rolandblok/sensor_satellite/photo/epaper.busy.broken.trace.jpg

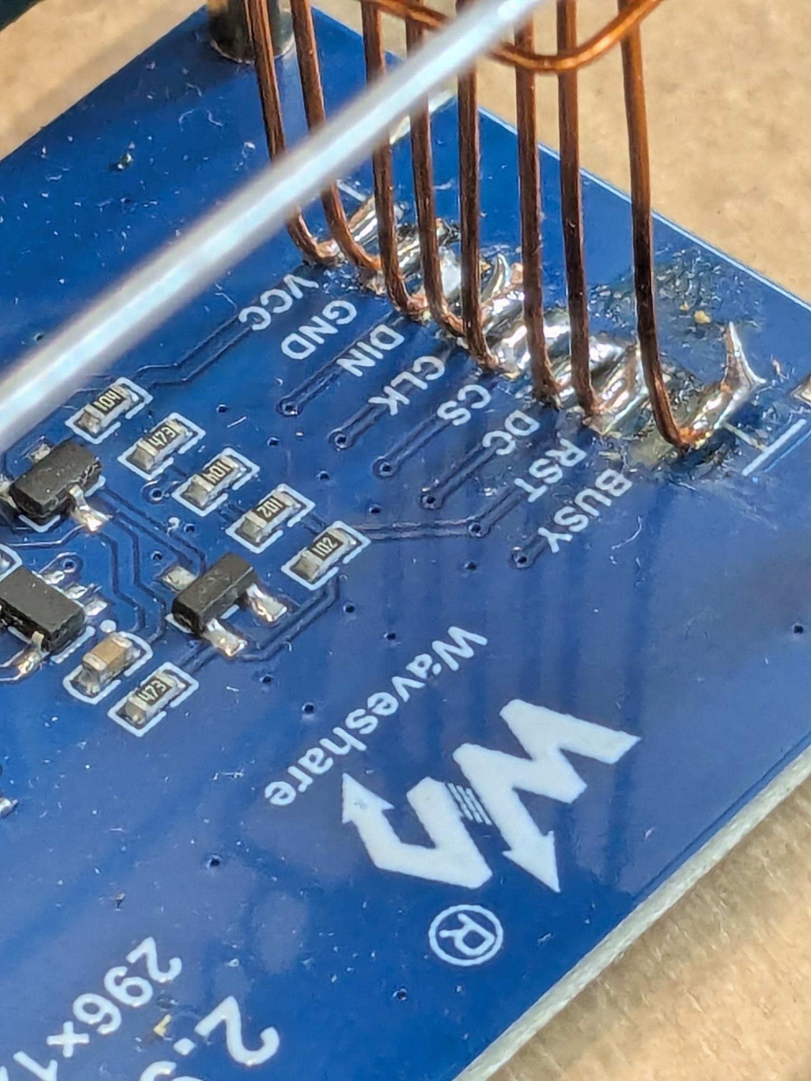
photo/epaper.busy.broken.trace.jpg
