rolandblok/sensor_satellite/photo/PXL_20261002_092657248 (Medium).jpg

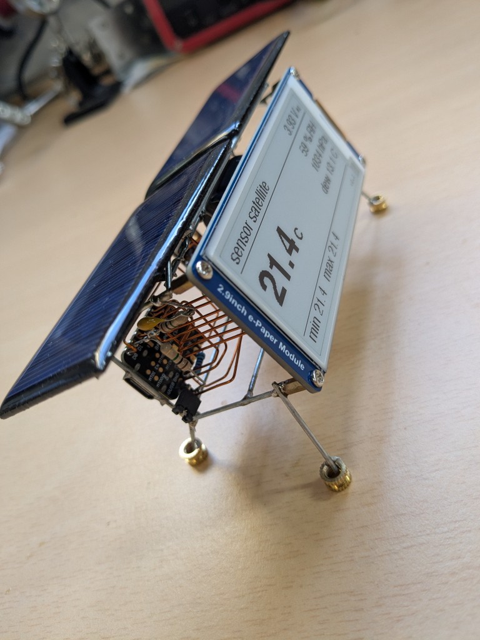
photo/PXL_20261002_092657248 (Medium).jpg
