rolandblok/sensor_satellite/photo/PXL_20261002_092710052 (Medium).jpg

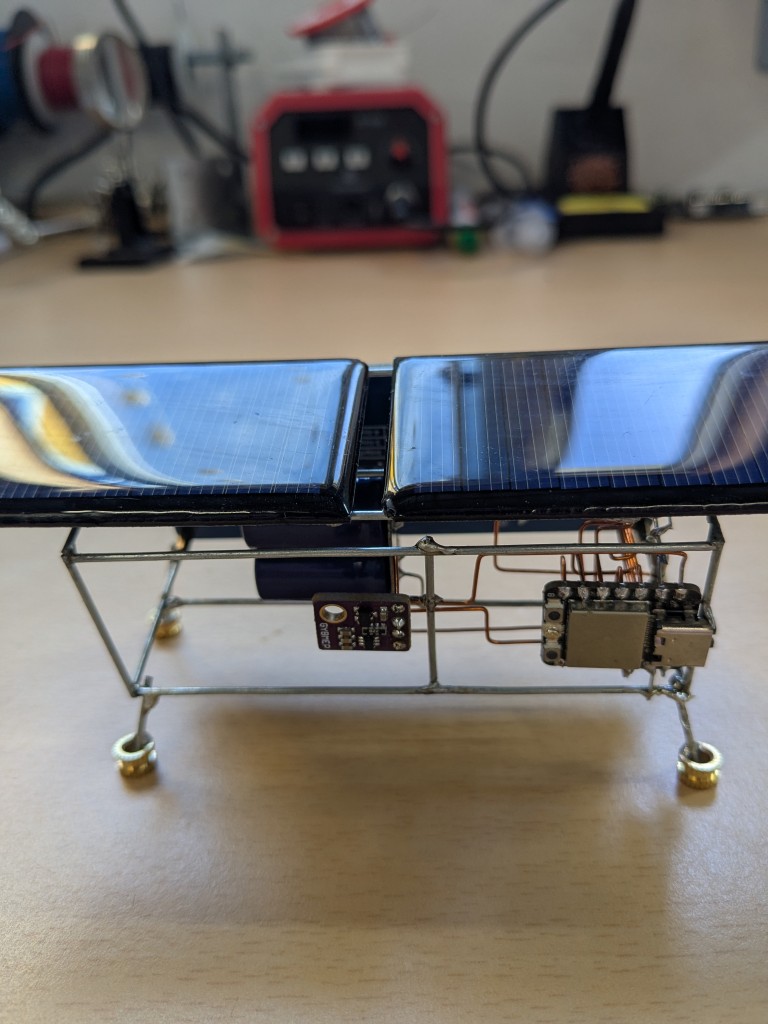
photo/PXL_20261002_092710052 (Medium).jpg
