rolandblok/sensor_satellite/photo/PXL_20261002_092730663 (Medium).jpg

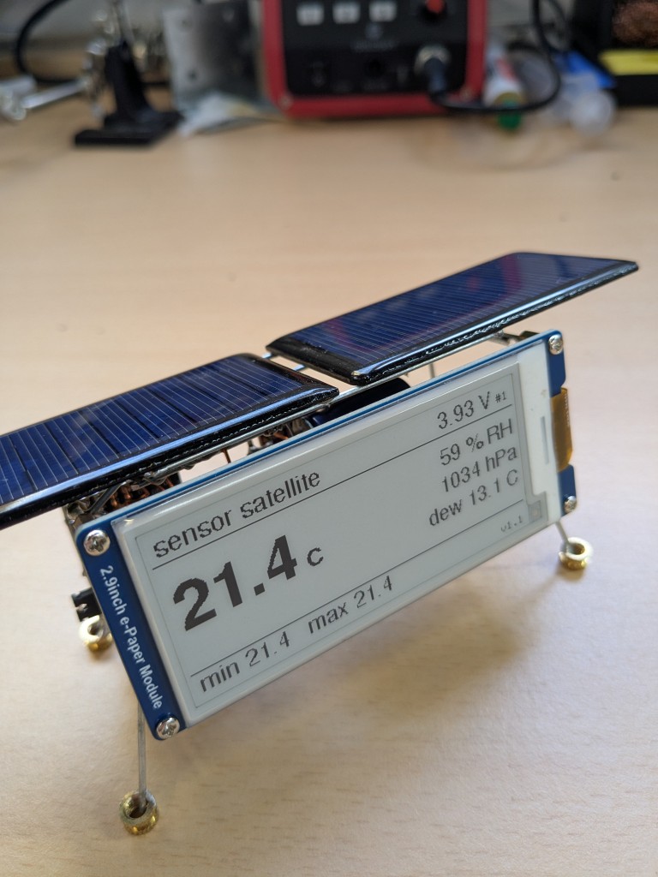
photo/PXL_20261002_092730663 (Medium).jpg
