rolandblok/sensor_satellite/photo/zoom_vreg.jpg

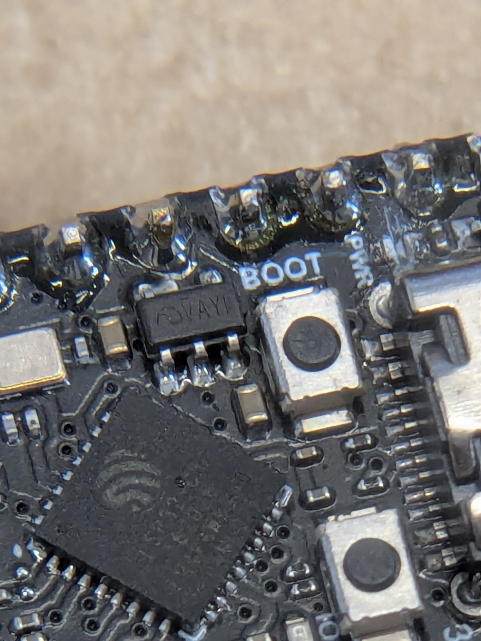
photo/zoom_vreg.jpg
