rolandblok/sensor_satellite/solar_node.pdf

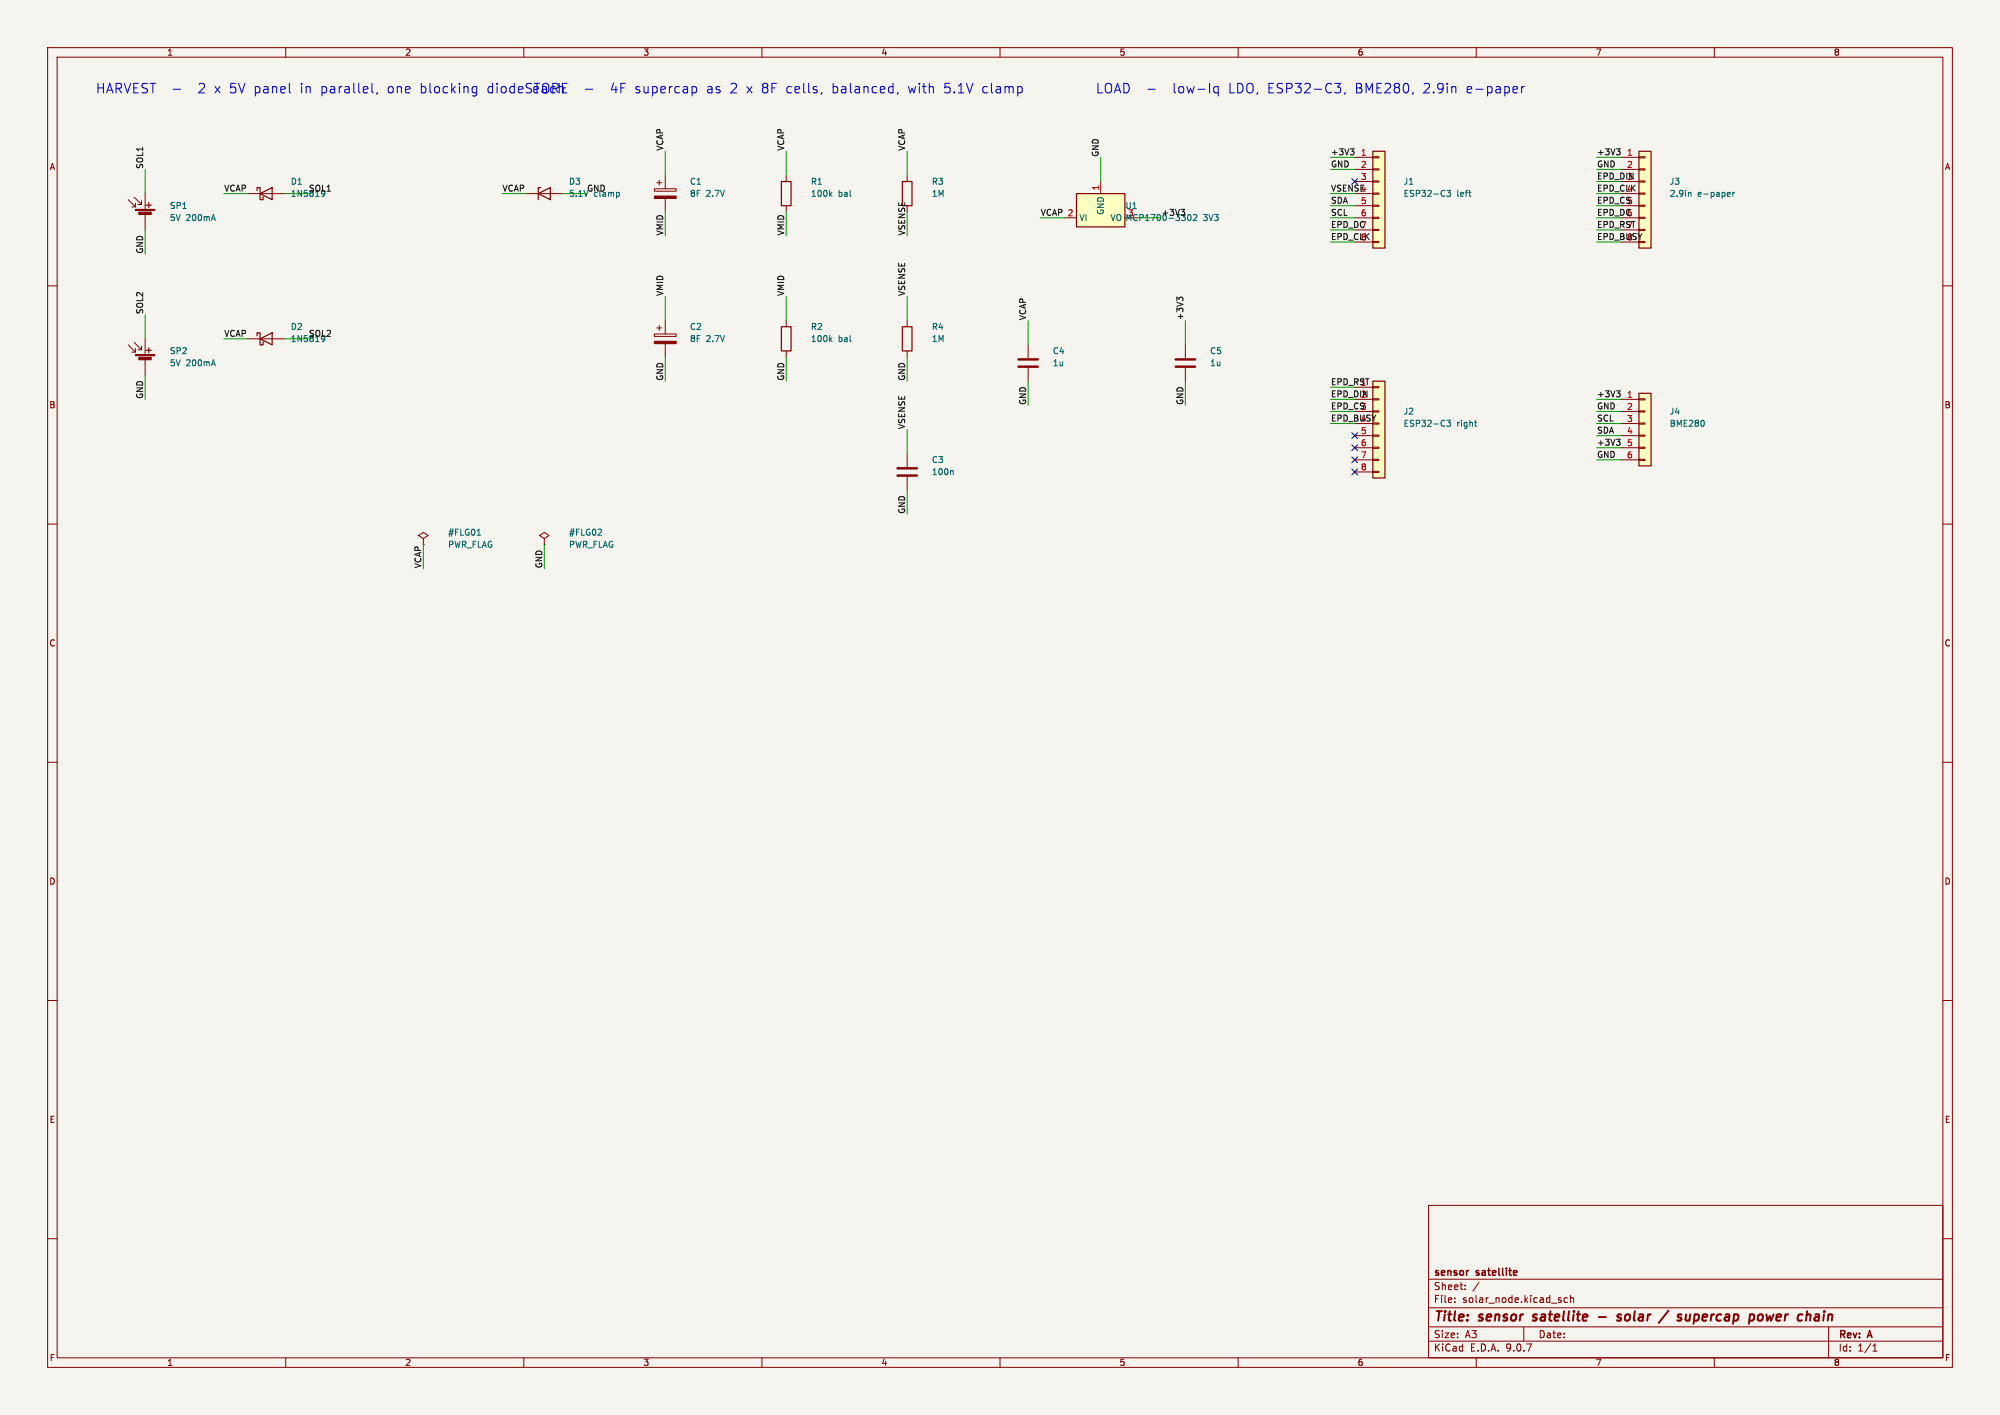
[picture p8: page 1]

File: solar_node.kicad_sch Sheet: / sensor satellite
