rolandblok/sensor_satellite/(commit log)

2026-08-01 Initial commit: ESP32-C3 + BME280 + 2.9 inch e-paper sensor node
    Firmware, wiring documentation and bring-up notes for a low-power
    environmental sensor node.
    - proto_epaper_esp32c3: BME280 over I2C plus Waveshare 2.9 inch e-paper
    (SSD1680) over SPI, CSV serial logging, dew point, sea-level pressure
    correction, sensor-fault frame on the panel
    - proto_oled_esp32c3: sensor-only build with serial logging
    - i2c_scan: sweeps every SDA/SCL pin pair to locate the bus
    [i2c_scan.ino, proto_epaper_esp32c3.ino, proto_oled_esp32c3.ino]
2026-08-21 Add tools: schematic generation, ERC check, scope logger
    scope_log.py drives a Rigol DS1054Z over LAN via SCPI and logs DC
    measurements to CSV. Handheld meters are more accurate for slow work but
    cannot be left alone for three hours, and indoor light moves enough that
    spot readings taken minutes apart are not comparable.
    Supports two channels plus a shunt resistor, which is how current is
    measured with an earth-referenced scope: both probe grounds stay on the
    ground rail and the subtraction floats, never the probe.
    Takes a PID lock on the output file. Two loggers writing one path
    interleave at different offsets and the result reads exactly like
    instrument noise - values that jump around an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
    [gen_schematic.py, scope_log.py]
2026-08-21 Add solar / supercapacitor power chain design
    Two 5 V panels in parallel, one blocking diode each, into a 5.5 V 4 F
    supercap, low-Iq LDO, then the existing ESP32-C3 node.
    Design notes cover why the panels are paralleled rather than seriesed and
    why each needs its own diode (a shared one blocks night discharge but lets
    a lit panel forward-bias a shaded one), the voltage ceiling and leakage
    floor, the two LDO stages, and how USB is diode-ORed in as a third source
    so it can be plugged in without a jumper or a rule to remember.
    The drawio carries four tabs: the block diagram, two bench-test wiring
    sheets with polarity and probe placement drawn explicitly, and the TO-92
    pinout sheet.
    The KiCad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
2026-08-21 Add 2026-08-21 supercap charge measurements
    419 samples over ~80 minutes of solar charging in indoor daylight, logged
    off the DS1054Z. Evidence behind the numbers in solar_node.md.
    Effective capacitance is not a single number: it rises from 3.85 F at
    1.5 V to 5.56 F at 4.5 V, from voltage dependence plus rate dependence as
    the charge current falls and charge reaches more of the porous electrode.
    The design's 4 F assumption stays fair, because the discharge case is the
    ESP at ~25 mA, where the shorter timescale pushes it back down.
    run2 contains a deliberate both-panels-covered window at t=1631-1702 s.
    With no current the shunt carries none, so the channels must read equal
    and the residual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
    [vcap_2ch_2026-08-21.csv, vcap_2ch_2026-08-21_run2.csv, vcap_charge_2026-08-21.csv]
2026-08-21 Reflect that the KiCad project is gone
    The docs claimed solar_node.kicad_sch was the authoritative version and
    told you to run ERC against it. That file was removed on 2026-08-21, so
    the instructions led nowhere.
    The netlist, the rendered PDF/SVG and gen_schematic.py survive and between
    them still pin the circuit down, so the file table now points at those.
    gen_schematic.py is kept and its docstring says plainly that it needs
    KiCad and will not run as things stand - the component and net
    declarations are the most precise description of the design in the repo,
    readable whether or not they can execute.
    check_schematic.py is removed. Its only job was validating a hand-edited
    .kicad_sch agains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
2026-08-28 Move Vcap sense to GPIO3, add the witness logger
    The supercapacitor divider was planned for GPIO2. That pin is a strapping pin
    that must be high at reset, and a divider holds it at Vcap / 2 -- so a flat cap
    holds it at 0 V and the board will not boot. It presents as a dead board rather
    than a bad reading, and every bench run starts from a flat cap. The sense tap
    moves to GPIO3 (ADC1_3, the only ADC1 channel left) and e-paper DC moves to
    GPIO21 to free it, which is safe because Serial is USB-CDC and UART0 is unused.
    Firmware:
    * GPIO3 read as millivolts, averaged over 32 samples, reported as a Vcap_V
    column appended to the existing CSV so column indices are unchanged.
    * I2C bus pinned to GP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
    [gen_schematic.py, logger_d1_mini.ino, proto_epaper_esp32c3.ino]
2026-08-28 Record where the Vcap bench rig left off
    Adds three things to solar_node.md that were established today but only lived in
    the session:
    * The sense dividers drain the cap continuously -- 10.2 uA total at 4.81 V -- and
    unplugging the logger's USB does not stop it, because the A0 network is passive
    resistors to a shared ground. Irrelevant for charge and discharge runs, but
    10-20% of the leakage floor being resolved, so pull the wire for those.
    * Which instrument to believe at which voltage. The node divides by 2, so its tap
    reaches the C3's ~2.5 V calibrated point at Vcap 5.0 V and compresses above it;
    the logger's full scale is 6.20 V and it keeps running below the 3.6 V dropout
    w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
2026-08-30 Add an OLED readout to the witness logger
    The logger now parses the node's Vcap out of the stream it relays and shows both
    measurements on a 128x64 SSD1306, so the rig can be watched without a terminal.
    Display:
    * The panel is dual-colour -- rows 0-15 yellow, 16-63 blue, fixed in the glass.
    Anything straddling y=16 comes out half one colour and reads as a fault, so the
    layout is built round the boundary: header above it, all numbers below. 9x15
    bold is the tallest cell that fits the yellow band whole.
    * Header counts down to the node's next expected row. The period is learned by
    timing the gap between received rows rather than hard-coding CYCLE_S, so the
    countdown stays honest whe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
    [logger_d1_mini.ino]
2026-09-03 investigations on power to high in sleep.
2026-09-03 Identify the GPIO8 pixel, add the XIAO as an alternative board
    The SuperMini in hand is a Plus V2: GPIO8 carries a WS2812B, not a blue
    LED. Its controller runs off 3V3 whatever the pin does and costs ~1 mA
    even showing black, so no firmware setting reaches it - only desoldering
    does. Corrects the "blue LED, active HIGH, 206 uA" note from 2026-09-03
    in gpio.md, proto_epaper_esp32c3.md and parkPins(); that 206 uA came out
    of the shunt session later thrown out for a ground loop, so it is now
    recorded as unexplained rather than as an LED.
    Adds the Seeed XIAO ESP32-C3 as an alternative board - same silicon, no
    user LED, no pixel. It brings out 11 GPIO instead of 13, so the I2C bus
    moves to SDA G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
    [proto_epaper_esp32c3.ino]
2026-09-04 XIAO pin map in firmware; HT7533 is required, measured
    Board switch in proto_epaper_esp32c3.ino - BOARD_XIAO selects the pin
    map, so one sketch builds for both boards. Only the I2C bus moves
    (SDA 20 / SCL 2); the e-paper and VSENSE pins are shared. USE_LOG_MIRROR
    compiles Serial0 out on the XIAO, since GPIO20 cannot be both SDA and the
    mirror TX. parkPins()/unparkPins() drop the standalone GPIO2 handling
    there, because GPIO2 is FORCE_SCL on that board. Also fixes a latent bug
    in the bus-discovery PINS[] list, which held GPIO0/GPIO1 - absent on the
    XIAO - and omitted GPIO20, where SDA actually lives.
    Power measurements, 2026-09-04. Fed at the 5V pin through the XIAO's
    onboard regulator, cons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
    [proto_epaper_esp32c3.ino]
2026-09-04 Sleep current is ~35 uA; the HT7533 is oscillating
    Ran tools/scope_log.py against the DS1054Z over LAN. XIAO + HT7533 +
    BME280 + e-paper on a lab supply, 10 ohm in the 5 V feed, CH1 across it,
    AVER acquisition. The log itself was discarded - power was reset on the
    XIAO mid-run and CH1's vertical scale moved from 1 to 5 mV/div. That is
    uncorrectable after the fact because the zero offset belongs to the
    range: +0.079 mV at 1 mV/div against +0.213 mV at 5 mV/div, both
    measured. Chasing why the numbers disagreed is what found the real
    problem.
    Node in deep sleep, zero-corrected, twelve samples:
    VMIN 0.6 mV 35 uA (sd 11) - the quiet floor
    VAVG 3.5 mV 325 uA (sd 14) - what the log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
2026-09-05 Show silk D-numbers in the XIAO as-wired diagram
    The as-wired diagram carried GPIO numbers only, while the pinout diagram
    above it carried both. Since the D-numbers and GPIO numbers do not
    correspond in any regular way, the drawing was the one place the mapping
    had to be looked up elsewhere. Both are now shown, silk inboard on the
    left and outboard on the right, so the crossover reads at a glance: D6
    is GPIO21 carrying DC on the left, D7 is GPIO20 carrying SDA on the
    right - adjacent on the chip, opposite sides of the board.
    Verified mechanically rather than by eye: both box walls and both silk
    columns land on single consistent columns, and all 11 GPIO/silk pairs
    cross-check against the per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
2026-09-05 It is an indoor tabletop sculpture, wired as 3D wire bends
    Two facts the repo never recorded, both load-bearing.
    No PCB. The connections are 3D wire bends that stand on their own and
    hold the modules in place - the wiring is the structure of a tabletop
    sculpture of a satellite. seed_mini_drawing.svg is the drawing of those
    traces and the build template; it is not a schematic or a layout. This
    is also why the KiCad project was dropped on 2026-08-21, which until now
    read as neglect rather than as a decision. Recorded in the README, in
    project.md's BOM section, and in solar_node.md next to the KiCad note.
    It lives indoors. Several design notes were written for an outdoor node
    and are wrong in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
2026-09-11 Order the XIAO's e-paper pins for the wire bends
    The panel's header order - DIN CLK CS DC RST - now runs straight down
    D2 to D6, so the wires lie parallel instead of crossing. There is no
    PCB; the connections are shaped wire that forms the sculpture's
    structure, so wire geometry is worth more here than electrical
    tidiness. The C3's GPIO matrix makes SPI pins free to place, and routing
    through the matrix rather than the IO-MUX caps the clock near 40 MHz
    against the panel's ~4 MHz, so it costs nothing.
    GPIO4 D2 DIN (was CLK)
    GPIO5 D3 CLK (was RST)
    GPIO6 D4 CS (was DIN)
    GPIO7 D5 RST (was CS)
    GPIO21 D6 DC unchanged
    DC and RST are one deliberate swa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
2026-09-11 Relabel the wire drawing for the new e-paper pin order
    Both views of seed_mini_drawing.svg now read DIN D2, CLK D3, CS D4,
    RST D5, DC D6, BUSY D10. Eight text substitutions, nothing else - the
    diff is labels only.
    The red wire paths are deliberately untouched, so four of the six
    e-paper traces now land a row or two off their label. Leaving that
    visible beats guessing: the paths are the sculpture's geometry, not a
    derivable consequence of the pin map, and a wrong-but-plausible reroute
    would be harder to spot than an obvious mismatch.
    Worth recording, because it decides what can be automated here: the
    sheet carries two views and they are not the same kind of drawing.
    Reading where each wire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
2026-09-18 Match the docs to the board: soldered pin order, BUSY gone
    Three hardware facts, all from the bench rather than the design.
    The wire-bend pin reorder was superseded by the soldering iron. The
    build was wired to the original order - CLK D2, RST D3, DIN D4, CS D5,
    DC D6 - which is electrically fine and satisfies the one constraint that
    matters, DC on GPIO21 and not RST. The e-paper defines were briefly
    board-conditional for the reorder and are merged again, since both
    boards are now wired the same. The cost is only that the runs cross
    rather than lie parallel; gpio_xiao.md keeps the reorder's reasoning as
    history in case it is ever resoldered.
    The panel's BUSY pad lifted and took a length of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
2026-09-25 Document the measured cycle and how to reach download mode
    CYCLE_S is back to 300 after the 60 s debug run, and the cycle is now
    measured rather than assumed: 308.3 s wake-to-wake, twice over to the
    tenth of a second, 9.1 s awake and ~299.2 s asleep, a 3.0% duty cycle.
    Two things fall out of that and are recorded with it. The period is
    CYCLE_S plus the awake time, because the timer is armed at the end of
    the cycle - so it is 300 s of sleep, not a 300 s period. And the 9.1 s
    is roughly 0.5 s of startup plus TWO ~4.35 s panel refreshes, because
    display.init() is called with initial = true and clears the panel before
    every draw. That doubling is the largest item in the energy budget once
    sleep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
2026-09-25 Drop the external LDO from the baseline, and the SuperMini's pinout with it
    The soldered sculpture has no HT7533. VCAP feeds the XIAO's 5V pin through a
    jumper and the onboard regulator makes 3V3; the other jumper position is USB,
    for reprogramming. The 40-50 uA measured on 2026-09-04 is therefore what an
    external LDO would buy, not what this board draws - note 8b, gpio_xiao.md and
    the README all say that now instead of "the external LDO stays in the design".
    Two gotchas had inverted themselves. The charge IC is in the circuit now, since
    its input sits on the 5V pin this build feeds, and the 40-50 uA run does not
    bound its quiescent current because that run bypassed it. And the hazard is no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
    [gen_schematic.py, proto_epaper_esp32c3.ino]
2026-09-27 Hold off updates on a weak cap, and log every wake to flash
    NOT YET RUN ON THE BOARD. All three configurations compile - XIAO with deep
    sleep, the USE_DEEP_SLEEP 0 bench build, and the SuperMini path - but a flaky
    USB link meant this was never flashed, so nothing here is measured. The three
    thresholds in particular are reasoned from the 3.04 V brownout of the
    2026-08-30 cap-only run, not from this board.
    The hold gate. 4 F is enormous next to this load, so a failed boot costs about
    1.5 mV: a brownout reset leaves Vcap where it was, the node retries at once,
    and it loops at ~20 mA, walking the cap down ~5 mV/s until the chip can no
    longer start. Every attempt buys zero readings. So Vcap is n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
    [proto_epaper_esp32c3.ino]
2026-09-27 Document the 10k pull-up on D8
    GPIO8 is a strapping pin; the resistor holds it high at reset and costs
    nothing while the firmware leaves the pad high-Z, which it does.
2026-09-27 Move the charge trend to the header, in small print
    The delta now follows Vcap at the top, and it and the boot counter use the
    version number's small font. The number is printed unsigned since the
    marker carries the direction - signed, next to the flat bar, it read as a
    double minus. Also notes the D8 pull-up in parkPins(). v1.1.
2026-10-03 Make thresholds and sleep times settings, and stop USB holding at the floor
    v1.2: a cold boot with a USB host attached skips the low-power gates. The
    divider reads the cap even on USB, so a plug-in with a flat cap slept at the
    floor before Serial came up and held forever - no port, no frame. The
    low-power frame is trimmed to two lines.
    v1.3: cycle_s, poll_s, v_hold, v_resume and v_floor live in NVS and are set
    over the serial console (p, s <name> <value>, r) without reflashing. Invalid
    sets are refused; a stored set that fails the check falls back to defaults.
    tools/dump_log.py saves the flash log under data/<date>/, and
    tools/node_cfg.py shows, sets and erases from the PC.
    Co-Authored-By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
    [dump_log.py, node_cfg.py, proto_epaper_esp32c3.ino]
2026-10-03 Analyse the first day-and-night panel run
    72 full cycles, then a hold at dusk and death at ~2.8 V two hours later. The
    held polls in the dark put the night drain at ~400 uA on 4 F, far more than a
    night can afford. tools/plot_log.py rebuilds a timeline from slept_s.
    [flashlog_162922.csv]
2026-10-03 Measure sleep current: the bare XIAO draws ~10-25 uA
    sleep_current/ holds the investigation: breadboard XIAO running
    sleep_probe, 10 ohm low-side shunt, scope zeroed in place with a wire
    across the shunt. The board alone sleeps at 25 uA at 5.0 V and 11-23 uA at
    4.0 V through its own regulator, so the 400 uA is elsewhere on the
    sculpture. Part 2 measures the sculpture through the VCAP jumper.
    scope_log.py now writes six decimals and keeps rows where one channel is
    off screen. Photos of the sculpture and its jumper added.
    [A2_4V0.csv, A2_4V0_10min.csv, A_5V0.csv, A_5V0_first_look.csv, Z_1mV_after_A2_4V0.csv, Z_1mV_after_A2_4V0_10min.csv, Z_1mV_after_A_5V0.csv]
2026-10-03 Add the VSENSE probe sketch
2026-10-03 Sculpture sleeps at ~0.9 mA on the lab supply, LED already removed
    First look at part 2: the whole sculpture on 4.5 V through the 10 ohm shunt,
    cap and panels cut off at the jumper. Sleep ~0.87-0.93 mA, ~40x the bare
    board, wake ~15 s at ~21 mA. The charge LED is confirmed desoldered, so the
    extra is the BME280 breakout or the e-paper module. Not yet zeroed, and CH1's
    probe was on 10x. Where this left off, and what is next, is at the end of the
    README.
    [S2_4V5.csv, S2_first_look.csv, S2_first_look2.csv, S2_first_look3.csv]
2026-10-04 Add park_epd setting, and make node_cfg survive the port resetting
    v1.4: park_epd (default 0) holds the e-paper's RST/CS high and SCK/MOSI/DC
    low through deep sleep, as an NVS setting so it can be A/B tested without
    reflashing. v1.3's stored settings are migrated, not reset to defaults.
    node_cfg.py reopens the port when the C3 resets under it on open, keeps
    its read buffer between calls, waits longer for the command window
    (--answer), and can erase the flash log (--erase).
    [node_cfg.py, proto_epaper_esp32c3.ino]
2026-10-04 Sculpture's ~0.9 mA sleep is hardware, not firmware
    Holding the e-paper lines (S3) changed nothing. sleep_probe, which never
    touches the BME280 or the panel, still sleeps at ~0.86 mA (P1-P3); the
    e-paper line states are worth ~0.1 mA, and commanding the BME280 to sleep
    and the e-paper into deep sleep does not help. LEDs, the D8 pull-up and
    VSENSE/cap are ruled out by measurement. Left: a module's own circuitry,
    the sculpture's own XIAO, or wiring leakage - next is unsoldering one VCC
    wire at a time.
    [P2_epd_states_4V5.csv, P3_cmd_sleep_4V5.csv, P_sleep_probe_4V5.csv, S3_park_epd1_4V5.csv]
2026-10-04 BME280 VCC off does not lower the sleep current
    With only the BME280's VCC wire unsoldered the sculpture sleeps at
    ~1.4-1.8 mA, drifting up - most likely the breakout back-powered through
    SDA/SCL, which the C3 holds high asleep. Next: unsolder SDA and SCL too.
    [U1_no_bme.csv, U1_no_bme_5mVdiv.csv]
2026-10-04 BME280 resoldered: sleep back at ~0.86 mA, I2C lines high
    Reflowing the BME280's GND and restoring its VCC brings the sculpture back
    to ~0.86 mA; SDA and SCL read high during sleep, so the breakout's pull-ups
    draw nothing. Unsoldering VCC alone back-powers a part through its signal
    lines, so the next split takes VCC and GND off together.
    [U2_bme_resoldered.csv]
2026-10-11 D8 pull-up costs nothing; the bare XIAO also sleeps two-level
    On the breadboard XIAO with sleep_probe v3, a 10k from 3V3 to D8 holds D8
    at 3.30 V through sleep and wake, so it draws ~0-3 uA. The first try read
    2.2 V on D8 from a poor breadboard contact and is discarded.
    The same bare board now sleeps at ~0.59 mA, with one sleep in ~6 at
    ~3.0 mA - not part 1's ~25 uA. A bare XIAO with nothing attached shows
    the sculpture's two-level sleep, so the cause is the XIAO or the
    firmware, not the modules. Also adds the overview of candidates for the
    sculpture's ~0.86 mA, and the next steps: tag each sleep's phase on D3,
    then compare with sleep_probe v1.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
2026-10-16 The 0.4/3 mA sleeps are sleep_probe v3, not the XIAO
    The jumper across the shunt is not a zero on a breadboard: it read
    1.1-3.1 mV and wandered, while the probe tip on its own ground clip reads
    a steady 0.43 mV. With that zero and the clips on the shunt's leads, the
    bare XIAO on v3 sleeps at 0.52 or 3.2 mA, about half the sleeps high, at
    random and not tied to v3's phases - also with 3.3 V straight into 3V3,
    so it is not the charger or the regulator. The D8 pull-up is off and D8
    plays no part.
    New sleep_min (2 s awake, 15 s deep sleep, nothing else) on the same
    board sleeps at ~15-90 uA with no high sleeps, with USB CDC off and on.
    So the firmware causes it. Next: sleep_min -DPARK=1, v3's p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
2026-10-23 Node v1.5: stop parking pins - the holds caused the 0.5/3 mA sleeps
    On the bare XIAO a sleep-only sketch draws ~20 uA. Adding the node's
    parkPins() - pulls latched with gpio_hold_en and gpio_deep_sleep_hold_en()
    before deep sleep, on pins with nothing attached - gives 0.51 or ~3 mA
    sleeps at random (N3). Node firmware v1.5 sets PARK_PINS 0 and sleeps at
    ~45-80 uA on both its hold path (N4) and its full-cycle path (N5).
    unparkPins() now runs whatever PARK_PINS says, since holds from an
    earlier build survive a reflash. CYCLE_S and HOLD_S can be overridden
    at build time for bench builds. sleep_min gains PARK_MASK/PARK_GLOBAL
    for a per-pin bisect, not yet run.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
2026-10-23 Sculpture on v1.5 sleeps at ~175 uA, down from 0.86 mA
    V1: node v1.5 (no pin holds) on the sculpture, hold path, steady ~175 uA
    with no second level. CYCLE_MIN_S makes the cycle_s minimum a build
    option so a bench test build can run 15 s cycles. Docs note park_epd is
    ignored since v1.5 and record the measured sleep current.
2026-10-30 Sculpture full cycle on v1.5: ~0.19 mA asleep, ~190 mC per wake
    V2/V3 on the lab supply, 15 s test build, panel refresh every wake.
    Sleep stays at ~170-200 uA; a wake averages ~16 mA for ~190 mC, and
    one in ~12 runs long (~270 mC). At 300 s that is ~0.8 mA average,
    three quarters of it the wake. CH3's probe is on 10x (V4 cross-check).
2026-11-06 MCP111 supervisor passes a loose bench test; holding reset costs ~0.49 mA
    The MCP111T-300E/TT trips between 2.8 and 2.9 V on a lab supply, which
    confirms the SOT-23-3 pinout. gpio_xiao.md documents the part, its wiring
    to the XIAO (VDD to 5V, VSS to GND, VOUT to EN) in one drawing, and why it
    needs no firmware change.
    R3: holding RESET on the sculpture draws ~0.49 mA, against ~0.165 mA
    asleep. The extra is the EN pull-up. R1 and R2 are not usable and are kept
    for the record.
